R34-GTt/Wireless_Controller/README.md

# Wireless_Controller

-Selfmade model railload wireless controller-

<ol>
<li>Introduction<br>
   This is microprocessor ESP32 based model railload wireless controller.<br>
   The concept is simple, make it easy to carry and easy to concentrate on driving.<br>
   ESP32 is a microprocessor developed by Espressif Systems, with built-in Wi-Fi and Bluetooth, low cost, low power consumption, and other features.
   Although there are many variations of the ESP32, i recommend using a development board that uses the ESP-WROOM-32D (e.g. ESP32-DevKitC-32D).
   The ESP32-DevKitC-32D can be purchased on Ebay, Aliexpress, etc. starting at $4. At this time, purchase with a built-in antenna model (Fig. 1).<br>
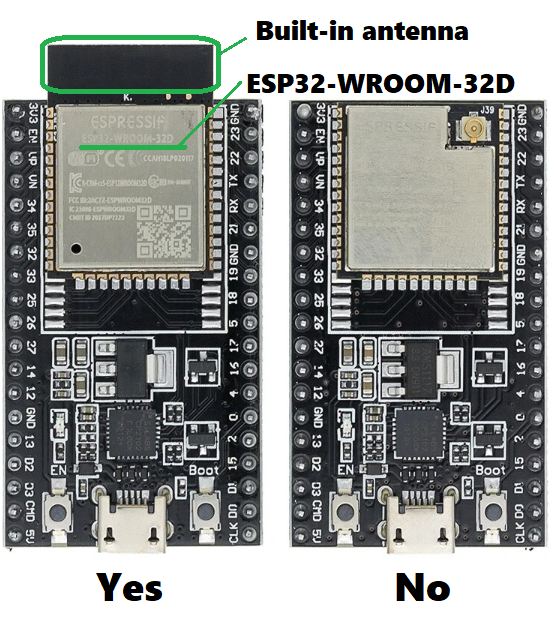
[picture p1: image/esp32.png]
   <br>
   　　Fig.1<br><br>
  This controller are build by Parant unit and Child unit. Both unit includes ESP32 and are connected by Wifi. So to program Parent unit and Child unit, you have to prepare Arduino development enviloment and add esp32 configration.<br>
   <br>
   The photo below shows the finished product.
   Two pairs of units are being created. One uses an old TOMIX controller as a case for the parent unit, and the other uses an old KATO case.
   Both of the child units are small plastic cases with mobile batteries strapped to them with rubber bands with Velcro.<br>
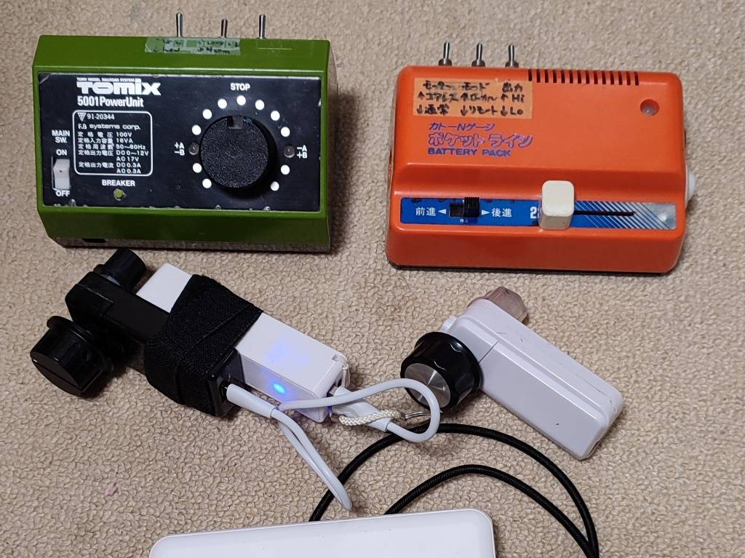
[picture p2: image/cont.jpg]
   <br>
   　　Fig.2<br><br>
   <br>
<li>Parent Unit<br>
   Parent unit is build by ESP32 and moterdriver mainly.<br>
   This is Parent unit schematic.<br>
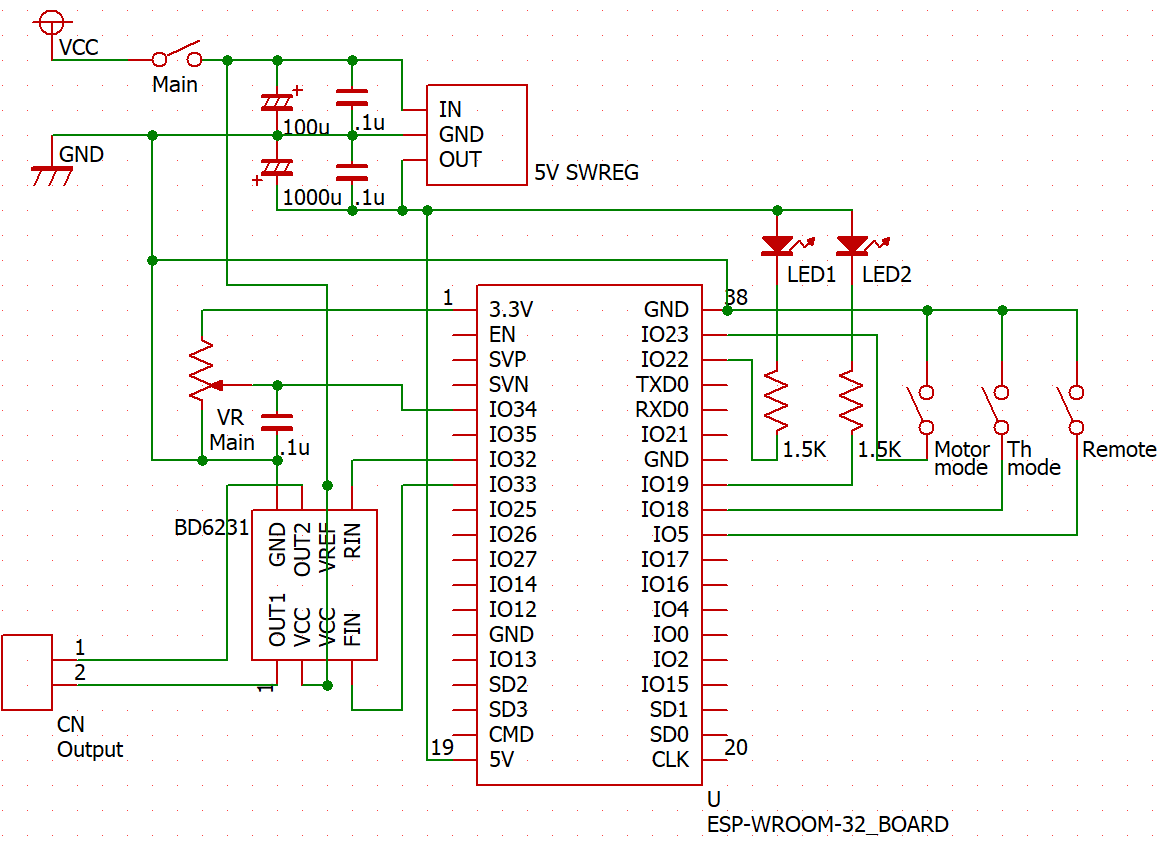
[picture p3: image/cont_p.png]
   <br>
   　　Fig.3<br><br>
   The roles of each component are as follows
   <ul>
   <li>Main switch (SW Main): Switch for the power supply of the entire controller. I use 12V 1.5A AC adapter for power supply.
   <li>5V Switching Regulator (5V SWREG): Supplies power to the ESP32 board, preferably with an output of 5V 1A or higher.
   <li>Motor Mode switch (Motor Mode): Switches motor driver control between On-Brake and On-Free. On-Brake seems to provide better controllability at lower speeds for coreless motors.
   <li>Throttle mode switch (Th Mode): Reduces the change in power output when the throttle is not opened very much. For coreless motors, it is recommended to set this switch to On.
   <li>Remote switch (Remote): Turns on/off wireless remote control.
   <li>Main volume (VR Main 10Kohm): Used to run the train when the remote mode is turned off. The position when the power is turned on is set to virtual midpoint, from which the train runs back and forth by turning it left or right. For this purpose, a potentiometer with a midpoint click should be used.
   <li>Motor driver BD6231: BD6231 is a 1A output motor driver. When using other motor drivers, use those that support PWM input. Also, the BD6231 has automatic output protection at 1.3A. Other motor drivers may not have such a function, so take appropriate output protection measures.
   <li>LED1, LED2: Indicators for running direction.
   </ul>
   
   Parent Unit's program is wpower_p.ino, you should modify Wifi-SSID and password at wpower_p.ino.<br>
<br>
<li>Child Unit<br>
   The child unit consists of an ESP32 and two potentiometers.<br>
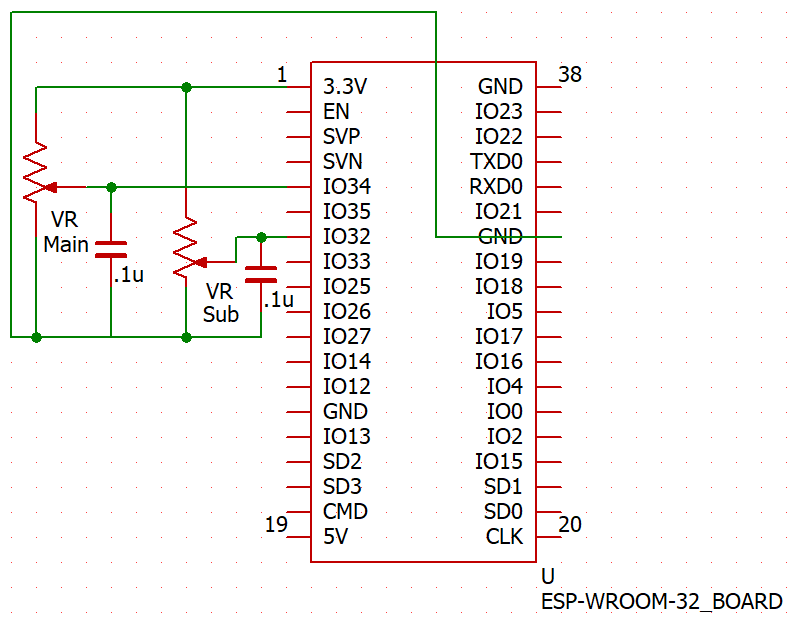
[picture p4: image/cont_c.png]
   <br>
   　　Fig.4<br><br>
   <ul>
   <li>Main volume (VR Main 10Kohm):Used to run the train when the remote mode is turned on. The position when the power is turned on is set virtual midpoint, from which the train runs back and forth by turning it left or right. For this purpose, a potentiometer with a midpoint click should be used.
   <li>Sub volume (VR Sub 10Kohm): This potentiometer is used to adjust the minimum output power. See Figure 5.<br>
   </ul>
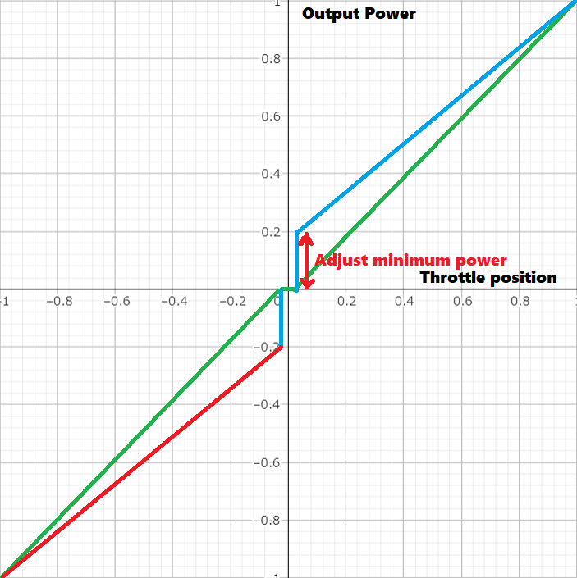
[picture p5: image/th.png]
   <br>
   　　Fig.5<br><br>
   At child unit, I use mobile battery for it's power source and connect ESP32 board via USB cable.
   Child Unit's program is wpower_c.ino, you should modify Wifi-SSID and password at wpower_c.ino(same as wpower_p.ino).<br>
<br>
<li>How to use<br>
   Turn on the parent unit first, then the child unit.　Before turn on child unit, Main volume have to set midpoint.<br>
</ol>
